hsetlik/GuitarProcessorH7/DSPPapers/paper_links.md

# DSP Papers

I don't want to track all these big pdfs in git, so I'll include this file with names and links to the papers in here

- "About this reverberation business" Moorer 1979: (https://www.music.mcgill.ca/~gary/courses/papers/Moorer-Reverb-CMJ-1979.pdf)
- "Designing multi-channel reverberators" Stautner and Puckette 1982: (https://www.ee.columbia.edu/~dpwe/e4896/papers/StautP82-reverb.pdf)
- "Effect Design" Dattorro 1997: (https://ccrma.stanford.edu/~dattorro/EffectDesignPart1.pdf)
