hsetlik/GuitarProcessorH7/Simulations/OutputStageSim.asc

C1: cap; 4n7
C2: cap; 4n7
C3: cap; 100n
C4: cap; 100n
R1: res; 1k
R2: res; 1k
R3: res; 100k
R4: res; 100k
R5: res; 51k
R6: res; 51k
R10: res; 100k
R11: res; 100k
U1: LT1058
U4: LT1058
V1: voltage; SINE(0.9 0.707 220 0 0 180)
V2: voltage; 9
V3: voltage; SINE(0.9 0.707 220)
Named nets: +9, 0, vg, LOL, LOR
.tran 0 80m 60m
