hsetlik/GuitarProcessorH7/GuitarProcessorBoard/GuitarProcessorBoard.kicad_pcb

## KiCad design GuitarProcessorBoard/GuitarProcessorBoard.kicad_pcb (2026-05-24)

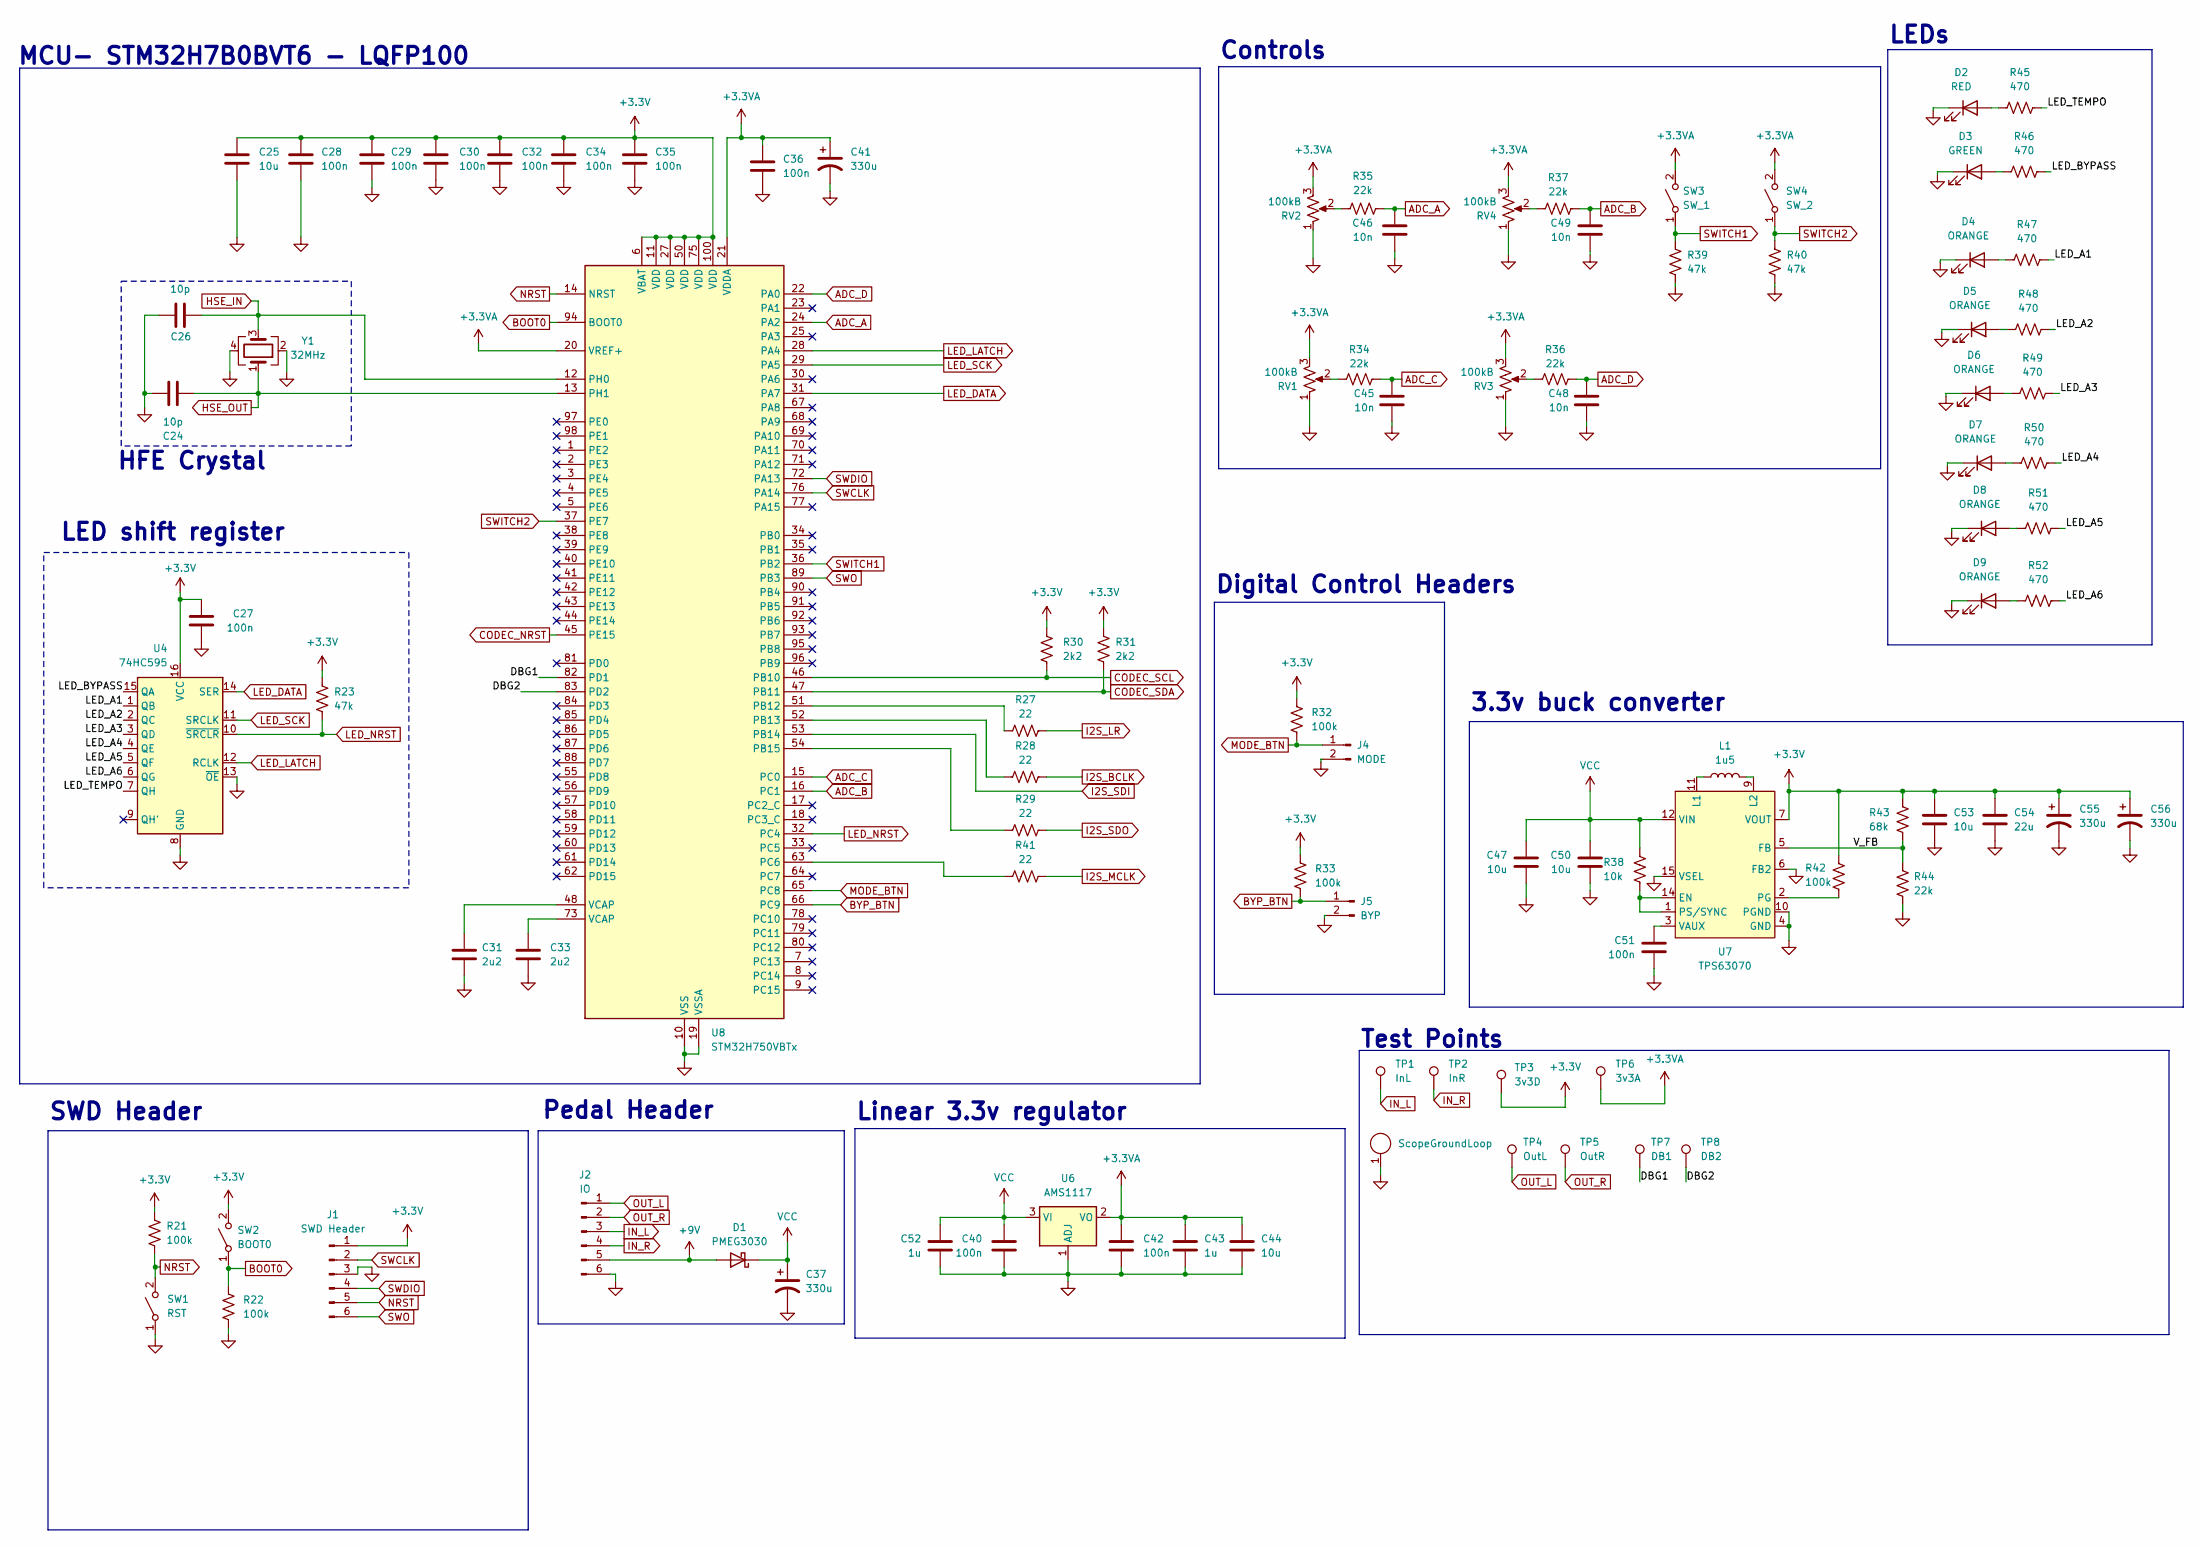
[picture p1: schematic MCU.kicad_sch]

Parts:
C24, C26: 10p; C_0805_2012Metric
C25, C44, C47, C50, C53: 10u; C_0805_2012Metric
C27, C28, C29, C30, C32, C34, C35, C36, C40, C42, C51: 100n; C_0805_2012Metric
C31, C33: 2u2; C_0805_2012Metric
C37, C41, C55, C56: 330u; CP_Radial_D5.0mm_P2.50mm
C43, C52: 1u; C_0805_2012Metric
C45, C46, C48, C49: 10n; C_0805_2012Metric
C54: 22u; C_0805_2012Metric
D1: PMEG3030; D_SOD-123
D2: RED; LED_D3.0mm
D3: GREEN; LED_D3.0mm
D4, D5, D6, D7, D8, D9: ORANGE; LED_D3.0mm
J1: SWD Header; PinHeader_1x06_P2.54mm_Vertical
J2: IO; PinHeader_1x06_P2.54mm_Vertical
J3: ScopeGroundLoop; THT_GND_WIRE
J4: MODE; PinHeader_1x02_P2.54mm_Vertical
J5: BYP; PinHeader_1x02_P2.54mm_Vertical
L1: 1u5; L_Coilcraft_XAL4020-XXX
R21, R22, R32, R33, R42: 100k; R_0805_2012Metric
R23, R39, R40: 47k; R_0805_2012Metric
R27, R28, R29, R41: 22; R_0805_2012Metric
R30, R31: 2k2; R_0805_2012Metric
R34, R35, R36, R37, R44: 22k; R_0805_2012Metric
R38: 10k; R_0805_2012Metric
R43: 68k; R_0805_2012Metric
R45, R46, R47, R48, R49, R50, R51, R52: 470; R_0805_2012Metric
RV1, RV2, RV3, RV4: 100kB; Potentiometer_Alpha_RD901F-40-00D_Single_Vertical_CircularH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
SW1: RST; SW_SPST_B3U-1000P
SW2: BOOT0; SW_SPST_B3U-1000P
SW3: SW_1; SW_TH_Tactile_Omron_B3F-102x
SW4: SW_2; SW_TH_Tactile_Omron_B3F-102x
TP1: InL; TestPoint_THTPad_D2.0mm_Drill1.0mm_VAL
TP2: InR; TestPoint_THTPad_D2.0mm_Drill1.0mm_VAL
TP3: 3v3D; TestPoint_THTPad_D2.0mm_Drill1.0mm_VAL
TP4: OutL; TestPoint_THTPad_D2.0mm_Drill1.0mm_VAL
TP5: OutR; TestPoint_THTPad_D2.0mm_Drill1.0mm_VAL
TP6: 3v3A; TestPoint_THTPad_D2.0mm_Drill1.0mm_VAL
TP7: DB1; TestPoint_THTPad_D2.0mm_Drill1.0mm_VAL
TP8: DB2; TestPoint_THTPad_D2.0mm_Drill1.0mm_VAL
U4: 74HC595; SOIC-16_3.9x9.9mm_P1.27mm
U6: AMS1117; SOT-223-3_TabPin2
U7: TPS63070; Converter_DCDC_TXN_QFN15
U8: STM32H750VBTx; LQFP-100_14x14mm_P0.5mm
Y1: 32MHz; Crystal_SMD_EuroQuartz_MT-4Pin_3.2x2.5mm

Connections:
+3.3V: C25.1, C27.1, C28.1, C29.1, C30.1, C32.1, C34.1, C35.1, C53.1, C54.1, C55.1, C56.1, J1.1, R21.1, R23.1, R30.1, R31.1, R32.1, R33.1, R42.1, R43.1, SW2.2 (B), TP3.1 (1_1), U4.16 (VCC), U7.7 (VOUT), U7.8 (VOUT), U8.6 (VBAT), U8.11 (VDD), U8.27 (VDD), U8.50 (VDD), U8.75 (VDD), U8.100 (VDD)
+3.3VA: C36.1, C41.1, C42.2, C43.1, C44.1, RV1.3, RV2.3, RV3.3, RV4.3, SW3.2 (B), SW4.2 (B), TP6.1 (1_1), U6.2 (VO), U8.20 (VREF+), U8.21 (VDDA); also elsewhere on the board
+9V: D1.2 (A), J2.5
/MCU/DBG1: TP7.1 (1_1), U8.82 (PD1)
/MCU/DBG2: TP8.1 (1_1), U8.83 (PD2)
/MCU/LED_A1: R47.2, U4.1 (QB)
/MCU/LED_A2: R48.2, U4.2 (QC)
/MCU/LED_A3: R49.2, U4.3 (QD)
/MCU/LED_A4: R50.2, U4.4 (QE)
/MCU/LED_A5: R51.2, U4.5 (QF)
/MCU/LED_A6: R52.2, U4.6 (QG)
/MCU/LED_BYPASS: R46.2, U4.15 (QA)
/MCU/LED_TEMPO: R45.2, U4.7 (QH)
/MCU/V_FB: R43.2, R44.1, U7.5 (FB)
ADC_A: C46.1, R35.2, U8.24 (PA2)
ADC_B: C49.1, R37.2, U8.16 (PC1)
ADC_C: C45.1, R34.2, U8.15 (PC0)
ADC_D: C48.1, R36.2, U8.22 (PA0)
BOOT0: R22.1, SW2.1 (A), U8.94 (BOOT0)
BYP_BTN: J5.1, R33.2, U8.66 (PC9)
CODEC_NRST: U8.45 (PE15); also elsewhere on the board
CODEC_SCL: R30.2, U8.46 (PB10); also elsewhere on the board
CODEC_SDA: R31.2, U8.47 (PB11); also elsewhere on the board
GND: C24.1, C25.2, C26.1, C27.2, C28.2, C29.2, C30.2, C31.2, C32.2, C33.2, C34.2, C35.2, C36.2, C37.2, C40.1, C41.2, C42.1, C43.2, C44.2, C45.2, C46.2, C47.2, C48.2, C49.2, C50.2, C51.2, C52.2, C53.2, C54.2, C55.2, C56.2, D2.1 (K), D3.1 (K), D4.1 (K), D5.1 (K), D6.1 (K), D7.1 (K), D8.1 (K), D9.1 (K), J1.3, J2.6, J3.1, J4.2, J5.2, R22.2, R39.2, R40.2, R44.2, RV1.1, RV2.1, RV3.1, RV4.1, SW1.1 (A), U4.8 (GND), U4.13 (~OE), U6.1 (ADJ), U7.4 (GND), U7.6 (FB2), U7.10 (PGND), U7.15 (VSEL), U8.10 (VSS), U8.19 (VSSA), U8.26 (VSS), U8.49 (VSS), U8.74 (VSS), U8.99 (VSS), Y1.2, Y1.4; also elsewhere on the board
HSE_IN: C26.2, U8.12 (PH0), Y1.3
HSE_OUT: C24.2, U8.13 (PH1), Y1.1
I2S_BCLK: R28.2; also elsewhere on the board
I2S_LR: R27.2; also elsewhere on the board
I2S_MCLK: R41.2; also elsewhere on the board
I2S_SDI: U8.53 (PB14); also elsewhere on the board
I2S_SDO: R29.2; also elsewhere on the board
IN_L: J2.3, TP1.1 (1_1); also elsewhere on the board
IN_R: J2.4, TP2.1 (1_1); also elsewhere on the board
LED_DATA: U4.14 (SER), U8.31 (PA7)
LED_LATCH: U4.12 (RCLK), U8.28 (PA4)
LED_NRST: R23.2, U4.10 (~SRCLR), U8.32 (PC4)
LED_SCK: U4.11 (SRCLK), U8.29 (PA5)
MODE_BTN: J4.1, R32.2, U8.65 (PC8)
NRST: J1.5, R21.2, SW1.2 (B), U8.14 (NRST)
unnamed: C31.1, U8.48 (VCAP)
unnamed: C33.1, U8.73 (VCAP)
unnamed: D2.2 (A), R45.1
unnamed: D3.2 (A), R46.1
unnamed: D4.2 (A), R47.1
unnamed: D5.2 (A), R48.1
unnamed: D6.2 (A), R49.1
unnamed: D7.2 (A), R50.1
unnamed: D8.2 (A), R51.1
unnamed: D9.2 (A), R52.1
unnamed: R34.1, RV1.2
unnamed: R35.1, RV2.2
unnamed: R36.1, RV3.2
unnamed: R37.1, RV4.2
unnamed: R38.2, U7.1 (PS/SYNC), U7.14 (EN)
unnamed: L1.1, U7.11 (L1)
unnamed: L1.2, U7.9 (L2)
unnamed: R42.2, U7.2 (PG)
unnamed: C51.1, U7.3 (VAUX)
unnamed: R27.1, U8.51 (PB12)
unnamed: R28.1, U8.52 (PB13)
unnamed: R29.1, U8.54 (PB15)
unnamed: R41.1, U8.63 (PC6)
OUT_L: J2.1, TP4.1 (1_1); also elsewhere on the board
OUT_R: J2.2, TP5.1 (1_1); also elsewhere on the board
SWCLK: J1.2, U8.76 (PA14)
SWDIO: J1.4, U8.72 (PA13)
SWITCH1: R39.1, SW3.1 (A), U8.36 (PB2)
SWITCH2: R40.1, SW4.1 (A), U8.37 (PE7)
SWO: J1.6, U8.89 (PB3)
VCC: C37.1, C40.2, C47.1, C50.1, C52.1, D1.1 (K), R38.1, U6.3 (VI), U7.12 (VIN), U7.13 (VIN); also elsewhere on the board

Notes on the sheet:
Pedal Header
3.3v buck converter
Linear 3.3v regulator
LED shift register
Test Points
HFE Crystal
LEDs
MCU- STM32H7B0BVT6 - LQFP100
SWD Header
Controls
Digital Control Headers

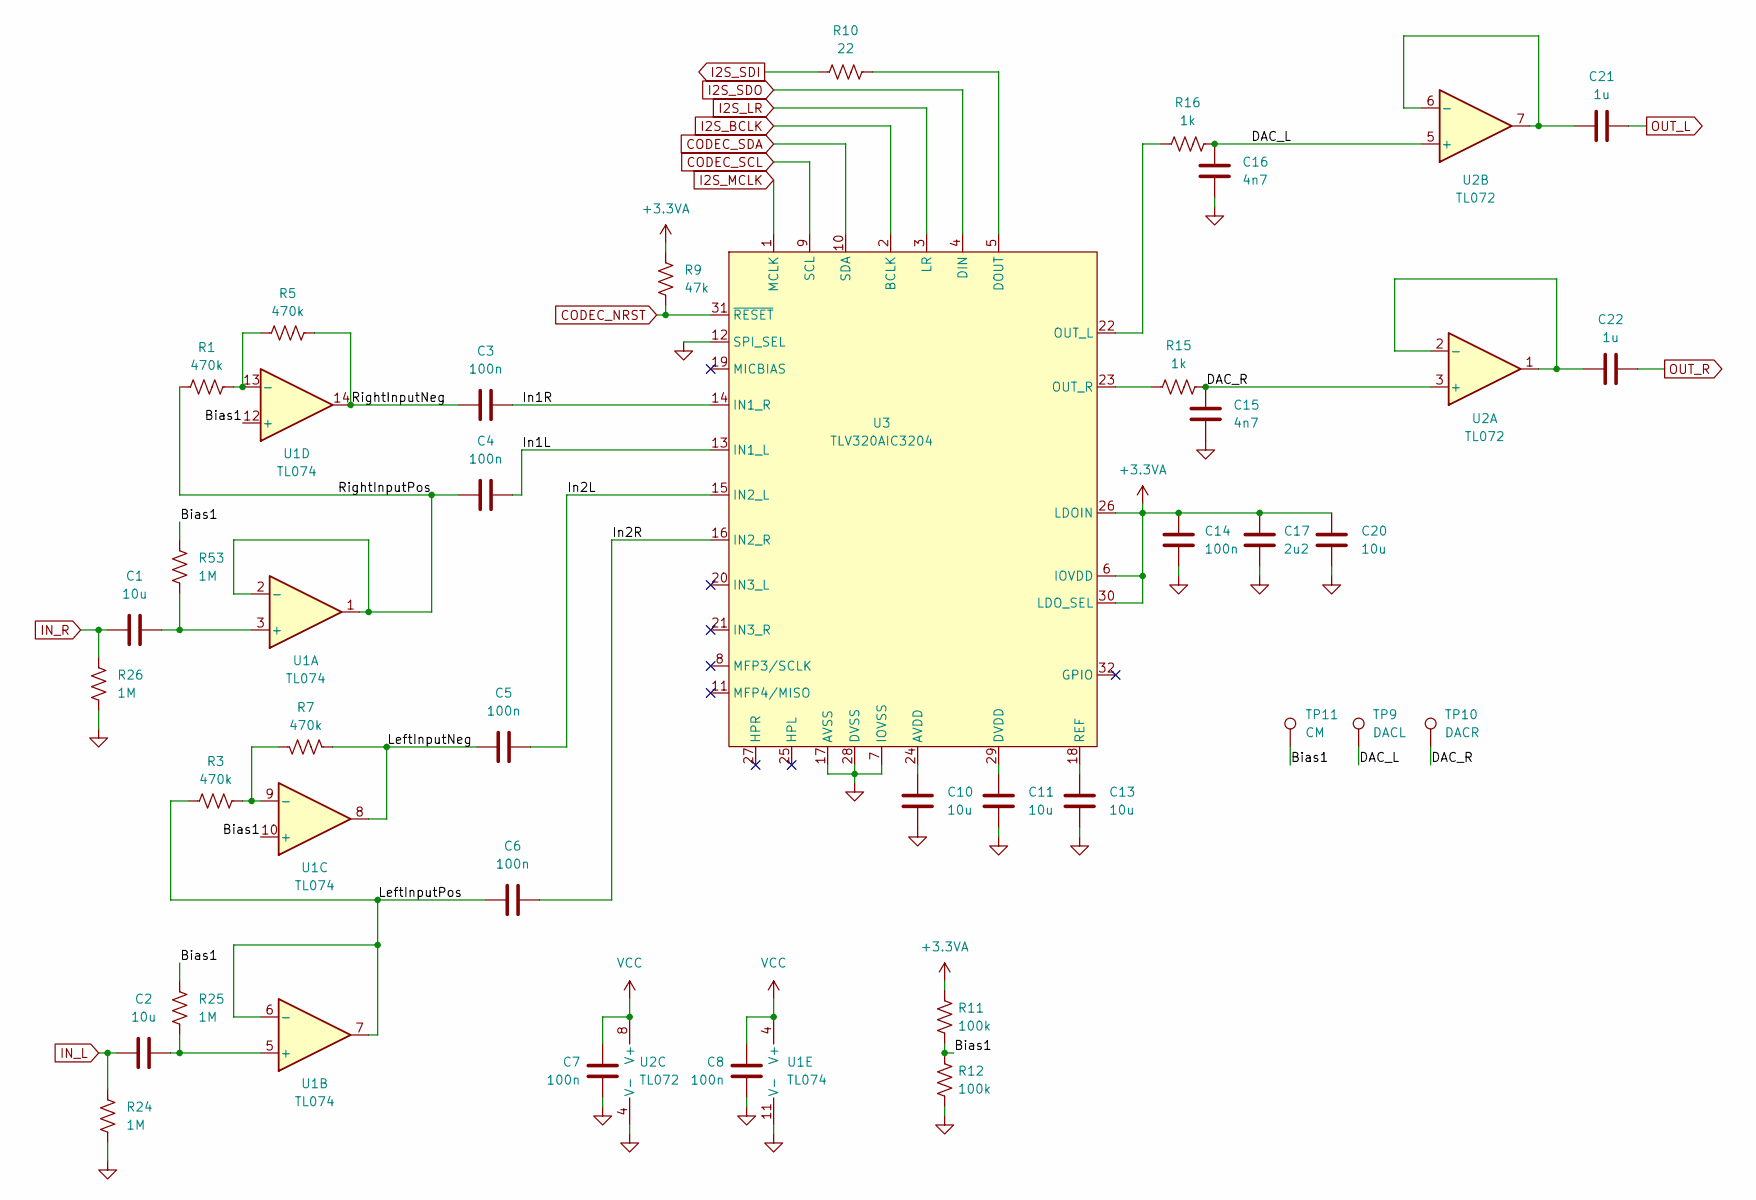
[picture p2: schematic Audio.kicad_sch]

Parts:
C1, C2, C10, C11, C13, C20: 10u; C_0805_2012Metric
C3, C4, C5, C6, C7, C8, C14: 100n; C_0805_2012Metric
C15, C16: 4n7; C_0805_2012Metric
C17: 2u2; C_0805_2012Metric
C21, C22: 1u; C_0805_2012Metric
R1, R3, R5, R7: 470k; R_0805_2012Metric
R9: 47k; R_0805_2012Metric
R10: 22; R_0805_2012Metric
R11, R12: 100k; R_0805_2012Metric
R15, R16: 1k; R_0805_2012Metric
R24, R25, R26, R53: 1M; R_0805_2012Metric
TP9: DACL; TestPoint_THTPad_D2.0mm_Drill1.0mm_VAL
TP10: DACR; TestPoint_THTPad_D2.0mm_Drill1.0mm_VAL
TP11: CM; TestPoint_THTPad_D2.0mm_Drill1.0mm_VAL
U1: TL074; SOIC-14_3.9x8.7mm_P1.27mm
U2: TL072; SOIC-8_3.9x4.9mm_P1.27mm
U3: TLV320AIC3204; VQFN-32-1EP_5x5mm_P0.5mm_EP3.1x3.1mm

Connections:
+3.3VA: C14.1, C17.1, C20.1, R9.1, R11.1, U3.6 (IOVDD), U3.26 (LDOIN), U3.30 (LDO_SEL); also elsewhere on the board
/Audio/Bias1: R11.2, R12.1, R25.1, R53.1, TP11.1 (1_1), U1.10 (+), U1.12 (+)
/Audio/DAC_L: C16.1, R16.2, TP9.1 (1_1), U2.5 (+)
/Audio/DAC_R: C15.1, R15.2, TP10.1 (1_1), U2.3 (+)
/Audio/In1L: C4.2, U3.13 (IN1_L)
/Audio/In1R: C3.2, U3.14 (IN1_R)
/Audio/In2L: C5.2, U3.15 (IN2_L)
/Audio/In2R: C6.2, U3.16 (IN2_R)
/Audio/LeftInputNeg: C5.1, R7.1, U1.8
/Audio/LeftInputPos: C6.1, R3.1, U1.6 (-), U1.7
/Audio/RightInputNeg: C3.1, R5.2, U1.14
/Audio/RightInputPos: C4.1, R1.1, U1.1, U1.2 (-)
CODEC_NRST: R9.2, U3.31 (~RESET); also elsewhere on the board
CODEC_SCL: U3.9 (SCL); also elsewhere on the board
CODEC_SDA: U3.10 (SDA); also elsewhere on the board
GND: C7.2, C8.2, C10.2, C11.2, C13.2, C14.2, C15.2, C16.2, C17.2, C20.2, R12.2, R24.2, R26.2, U1.11 (V-), U2.4 (V-), U3.7 (IOVSS), U3.12 (SPI_SEL), U3.17 (AVSS), U3.28 (DVSS), U3.33 (TP); also elsewhere on the board
I2S_BCLK: U3.2 (BCLK); also elsewhere on the board
I2S_LR: U3.3 (LR); also elsewhere on the board
I2S_MCLK: U3.1 (MCLK); also elsewhere on the board
I2S_SDI: R10.1; also elsewhere on the board
I2S_SDO: U3.4 (DIN); also elsewhere on the board
IN_L: C2.1, R24.1; also elsewhere on the board
IN_R: C1.1, R26.1; also elsewhere on the board
unnamed: C1.2, R53.2, U1.3 (+)
unnamed: C2.2, R25.2, U1.5 (+)
unnamed: R3.2, R7.2, U1.9 (-)
unnamed: R1.2, R5.1, U1.13 (-)
unnamed: C22.1, U2.1, U2.2 (-)
unnamed: C21.1, U2.6 (-), U2.7
unnamed: C10.1, U3.24 (AVDD)
unnamed: R10.2, U3.5 (DOUT)
unnamed: C11.1, U3.29 (DVDD)
unnamed: R16.1, U3.22 (OUT_L)
unnamed: R15.1, U3.23 (OUT_R)
unnamed: C13.1, U3.18 (REF)
OUT_L: C21.2; also elsewhere on the board
OUT_R: C22.2; also elsewhere on the board
VCC: C7.1, C8.1, U1.4 (V+), U2.8 (V+); also elsewhere on the board

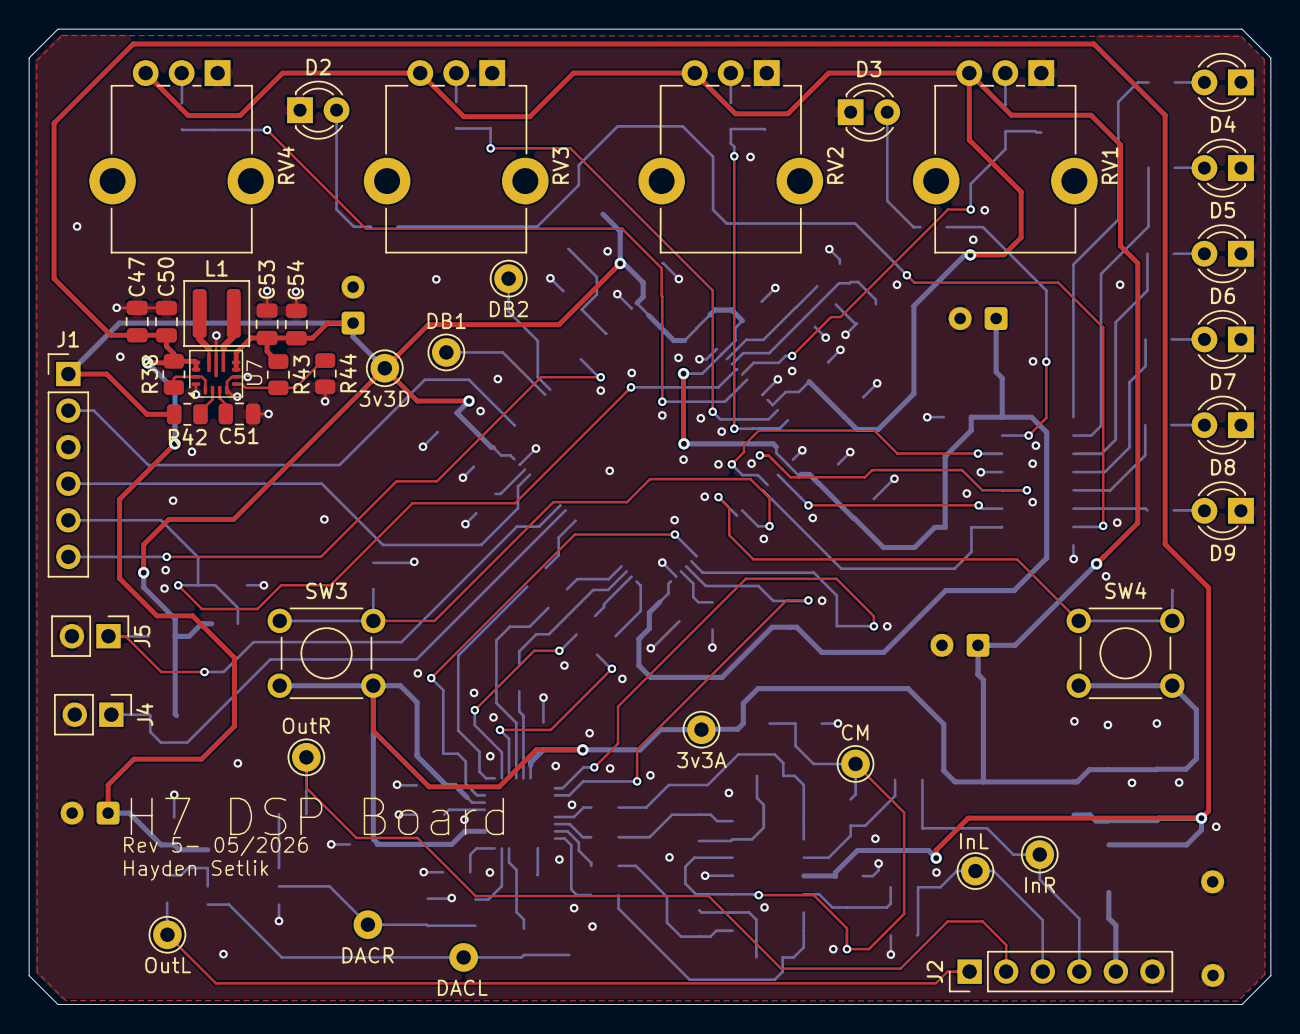
[picture p3: board GuitarProcessorBoard.kicad_pcb from above]

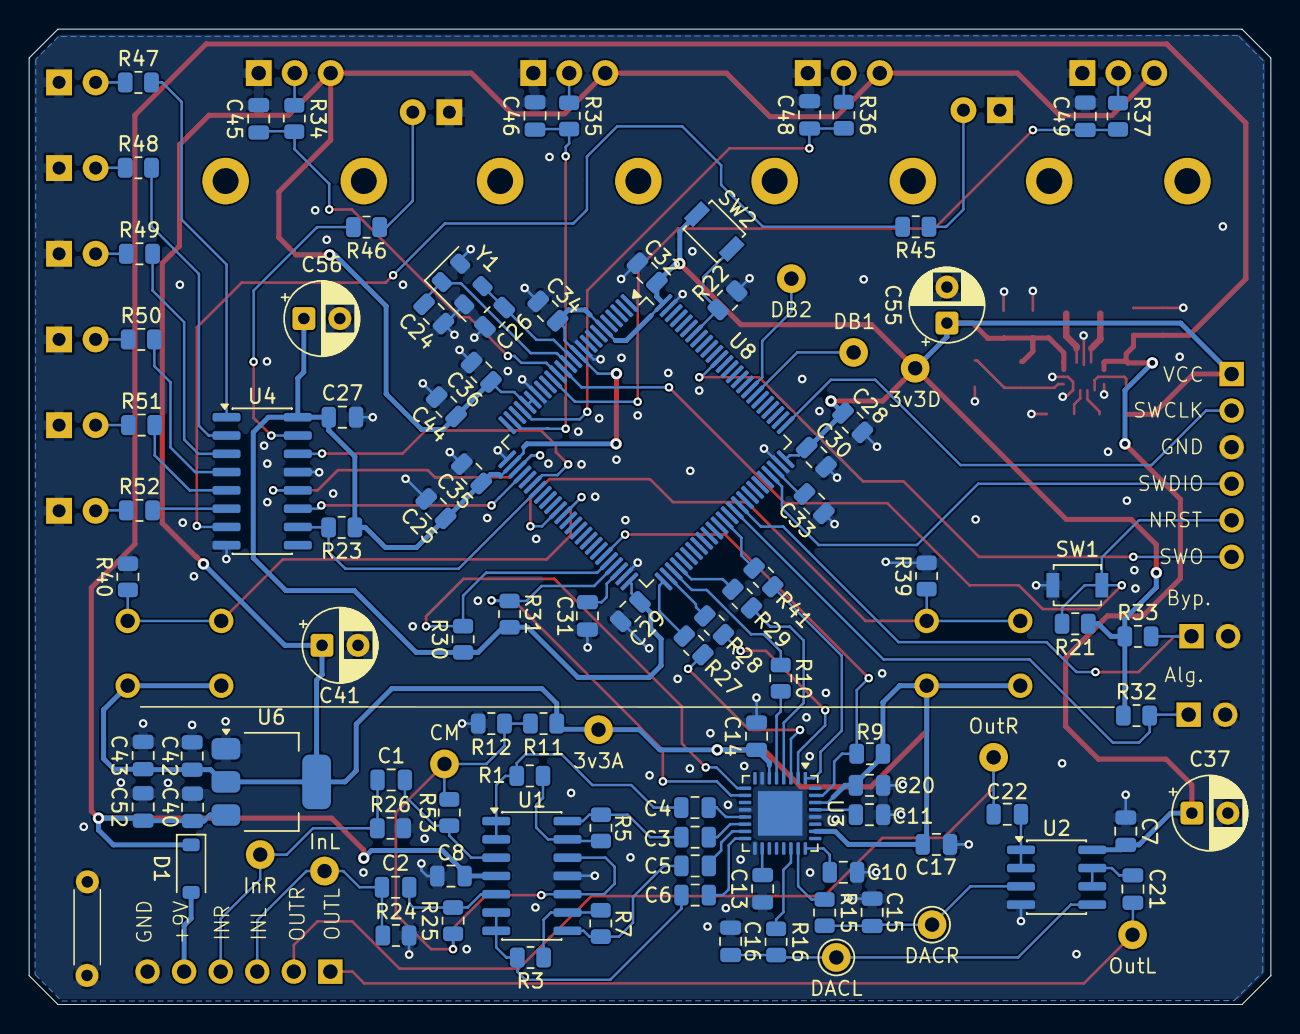
[picture p4: board GuitarProcessorBoard.kicad_pcb from below]

Board: 4 copper layers, 86.3 x 67.8 mm, 134 parts (96 on the bottom side), 93 nets.
