hsetlik/GuitarProcessorH7/GuitarProcessorFirmware/Core/Src/main.c

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
/* Includes ------------------------------------------------------------------*/
#include "main.h"

/* USER CODE BEGIN Includes */
#include "Button.h"
#include "stm32h7xx_hal.h"
#include "stm32h7xx_hal_adc.h"
#include "stm32h7xx_hal_adc_ex.h"
#include "stm32h7xx_hal_def.h"
#include "stm32h7xx_hal_gpio.h"
#include "stm32h7xx_hal_tim.h"
#include "tlv320aic3204.h"
#include "PedalState.h"
#include "FxProcessor.h"
/* USER CODE END Includes */

/* USER CODE BEGIN PM */
#define INPUT_DC_OFFSET 100000
/* USER CODE END PM */

ADC_HandleTypeDef hadc1;
DMA_HandleTypeDef hdma_adc1;

I2C_HandleTypeDef hi2c2;

I2S_HandleTypeDef hi2s2;
DMA_HandleTypeDef hdma_spi2_rx;
DMA_HandleTypeDef hdma_spi2_tx;

SPI_HandleTypeDef hspi1;
DMA_HandleTypeDef hdma_spi1_tx;

TIM_HandleTypeDef htim3;
TIM_HandleTypeDef htim4;
TIM_HandleTypeDef htim6;
TIM_HandleTypeDef htim7;

/* USER CODE BEGIN PV */
// buffers for the input & output audio streams
isample_t adcBuf[AUDIO_BUF_SIZE * 4]  __attribute__((section(".dma_buf")));
float inputBufLeft[AUDIO_BUF_SIZE];
float inputBufRight[AUDIO_BUF_SIZE];
float outputBufLeft[AUDIO_BUF_SIZE];
float outputBufRight[AUDIO_BUF_SIZE];
isample_t dacBuf[AUDIO_BUF_SIZE * 4] __attribute__((section(".dma_buf")));
static isample_t* adcPtr = adcBuf;
static isample_t* dacPtr = dacBuf;
// flags
volatile bool chunkReady = false;
volatile bool ledUpdateNeeded = false;
volatile bool flagCheckNeeded = false;
volatile bool processRunning = false;
isample_t leftDcBias = 0;

// knob values and ADC buffer
volatile uint16_t knobValueBuf[4] __attribute__((section(".dma_buf")));
volatile bool knobValuesReady = false;

// button objects
button_t leftBtn;
button_t rightBtn;

// state
uint8_t ledData __attribute__((section(".dma_buf")));
pedal_state_t ps;
fx_processor_t fx;

/* USER CODE END PV */

void SystemClock_Config(void);
static void MPU_Config(void);
static void MX_GPIO_Init(void);
static void MX_DMA_Init(void);
static void MX_ADC1_Init(void);
static void MX_I2C2_Init(void);
static void MX_I2S2_Init(void);
static void MX_SPI1_Init(void);
static void MX_TIM3_Init(void);
static void MX_TIM4_Init(void);
static void MX_TIM7_Init(void);
static void MX_TIM6_Init(void);
/* USER CODE BEGIN PFP */
void startKnobADC();
void loadInputBuf(isample_t* ptr);
void loadOutputBuf(isample_t* dac);
/* USER CODE END PFP */

/* USER CODE BEGIN 0 */
bool ledUpdateDue() {
  return ledUpdateNeeded;
}

void updateLedData(uint8_t data){
  ledData = data;
  HAL_StatusTypeDef ledStatus = HAL_SPI_Transmit_DMA(&LED_SPI, &ledData, 1); 
  if(ledStatus != HAL_OK){
    Error_Handler();
  }
  ledUpdateNeeded = false;
}

bool algSwitchDebounce(){
	static uint16_t switchStates = 0xFFFF;
	switchStates = (switchStates << 1)
			| HAL_GPIO_ReadPin(MODE_GPIO_Port, MODE_Pin);
	return switchStates == 0xFFF0;
}

void setDBG1Level(bool isHigh){
  GPIO_PinState state = (GPIO_PinState)isHigh;
  HAL_GPIO_WritePin(DBG1_GPIO_Port, DBG1_Pin, state);
}

void setDBG2Level(bool isHigh){
  GPIO_PinState state = (GPIO_PinState)isHigh;
  HAL_GPIO_WritePin(DBG2_GPIO_Port, DBG2_Pin, state);
}

uint16_t i2c_scan(I2C_HandleTypeDef *hi2c) {
    for (uint8_t addr = 1; addr < 128; addr++) {
        // HAL expects the address left-shifted by 1
        if (HAL_I2C_IsDeviceReady(hi2c, addr << 1, 1, 10) == HAL_OK) {
            // device found at 7-bit address `addr`
          return (uint16_t)(addr << 1);   
        }
    }
    Error_Handler();
    return 0;
}

/* USER CODE END 0 */

/**
  * @brief  The application entry point.
  * @retval int
  */
int main(void)
{

  /* MPU Configuration--------------------------------------------------------*/
  MPU_Config();

  /* MCU Configuration--------------------------------------------------------*/

  /* Reset of all peripherals, Initializes the Flash interface and the Systick. */
  HAL_Init();

  /* Configure the system clock */
  SystemClock_Config();

  /* Initialize all configured peripherals */
  MX_GPIO_Init();
  MX_DMA_Init();
  MX_ADC1_Init();
  MX_I2C2_Init();
  MX_I2S2_Init();
  MX_SPI1_Init();
  MX_TIM3_Init();
  MX_TIM4_Init();
  MX_TIM7_Init();
  MX_TIM6_Init();
  /* USER CODE BEGIN 2 */
  // find any valid I2C devices
  //uint16_t address = i2c_scan(&hi2c2);
  // initialize the audio codec
  HAL_StatusTypeDef tlvStatus = TLV_quickInit_stereoGuitarPedal();
  if(tlvStatus != HAL_OK){
    Error_Handler();
  }

  HAL_Delay(150);

  HAL_StatusTypeDef dmaStatus = HAL_I2SEx_TransmitReceive_DMA(&hi2s2, (uint16_t*)dacBuf, (uint16_t*)adcBuf, AUDIO_BUF_SIZE * sizeof(isample_t));
  if(dmaStatus != HAL_OK){
    Error_Handler();
  }

  //TLV_checkFlags();

  // calibrate the ADC
  if(HAL_ADCEx_Calibration_Start(&hadc1, ADC_CALIB_OFFSET, ADC_SINGLE_ENDED) != HAL_OK){
    Error_Handler();
  }

  // start the timer for the knobs
  if(HAL_TIM_Base_Start(&htim4) != HAL_OK){
    Error_Handler();
  }

  startKnobADC();

  PedalState_init(&ps);
  HAL_GPIO_WritePin(LED_NRST_GPIO_Port, LED_NRST_Pin, GPIO_PIN_SET);
  // start the timer for the LED updating
  if(HAL_TIM_Base_Start_IT(&htim3) != HAL_OK){
    Error_Handler();
  }
  HAL_Delay(350);
  // initialize the button objects
  button_init(&leftBtn, SW_1_GPIO_Port, SW_1_Pin, true);
  button_init(&rightBtn, SW_2_GPIO_Port, SW_2_Pin, true);
   // start the timer for checking the buttons
  if(HAL_TIM_Base_Start_IT(&htim7) != HAL_OK){
    Error_Handler();
  } 
  init_dc_measurement_buf();
  // // start the flag checking timer
  // if(HAL_TIM_Base_Start_IT(&htim6) != HAL_OK){
  //   Error_Handler();
  // } 
  // // enable DC measurement on the ADCs
  // if(TLV_enableDcMeasurement() != HAL_OK){
  //   Error_Handler();
  // }
  // initialize the fx processor
  fx = create_fx_processor();
  /* USER CODE END 2 */

  /* Infinite loop */
  /* USER CODE BEGIN WHILE */
  while (1)
  {
    if(chunkReady){
      //do processing here
      setDBG2Level(true);
      loadInputBuf(adcPtr);
      processRunning = true;
      setDBG1Level(true);
      process_fx_stereo(fx, inputBufLeft, inputBufRight, outputBufLeft, outputBufRight, AUDIO_BUF_SIZE);
      setDBG1Level(false);
      processRunning = false;
      loadOutputBuf(dacPtr);
      setDBG2Level(false);
      chunkReady = false;
    }
    if(knobValuesReady){
      ps.knobA = (float)knobValueBuf[0] / 4096.0f;
      ps.knobB = (float)knobValueBuf[1] / 4096.0f;
      ps.knobC = (float)knobValueBuf[2] / 4096.0f;
      ps.knobD = (float)knobValueBuf[3] / 4096.0f;
      update_params(fx, &ps);
      knobValuesReady = false;
      startKnobADC();
    }
    if(ledUpdateDue()){
      // check the switches while we're here
      ps.fxEngaged = HAL_GPIO_ReadPin(BYP_GPIO_Port, BYP_Pin);
      ps.expButton = HAL_GPIO_ReadPin(MODE_GPIO_Port, MODE_Pin);
      updateLedData(PedalState_getLedData(&ps));
    }
    // if(flagCheckNeeded){
    //   if(TLV_leftDcMeasurementReady()){
    //     leftDcBias = TLV_getDcMeasurementLeft();
    //   }
    //   flagCheckNeeded = false;
    // }
    /* USER CODE END WHILE */

    /* USER CODE BEGIN 3 */
  }
  /* USER CODE END 3 */
}

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
/* USER CODE BEGIN 4 */

// I2S callbacks===================================
void HAL_I2SEx_TxRxCpltCallback(I2S_HandleTypeDef *i2s) {
  if(processRunning){
    Error_Handler();
  }
	adcPtr = &adcBuf[AUDIO_BUF_SIZE * 2];
	dacPtr = &dacBuf[AUDIO_BUF_SIZE * 2];
  chunkReady = true;
}

void HAL_I2SEx_TxRxHalfCpltCallback(I2S_HandleTypeDef *i2s) {
  if(processRunning){
    Error_Handler();
  }
	adcPtr = &adcBuf[0];
	dacPtr = &dacBuf[0];
  chunkReady = true;
}

// void HAL_I2S_ErrorCallback(I2S_HandleTypeDef *hi2s){
//   uint32_t errCode = HAL_I2S_GetError(hi2s);
// }

static inline float sampleToFloat(isample_t value){
    return (float)value / 2147483648.0f;  // 2^31
}

static inline isample_t floatToSample(float value){
  return (isample_t)(value * 2147483648.0f);
}

void loadInputBuf(isample_t* ptr){
  for(uint32_t i = 0; i < AUDIO_BUF_SIZE; ++i){
    inputBufLeft[i] = sampleToFloat(ptr[(i * 2) + 1]);
    inputBufRight[i] = sampleToFloat(ptr[(i * 2)]);
  }
}

void loadOutputBuf(isample_t* dac){
  for(uint32_t i = 0; i < AUDIO_BUF_SIZE; ++i){
    dac[(i * 2) + 1] = floatToSample(outputBufLeft[i]);
    dac[(i * 2)] = floatToSample(outputBufRight[i]);
  } 
}

void HAL_ADC_ConvCpltCallback(ADC_HandleTypeDef *hadc){
  knobValuesReady = true;
}

void HAL_ADC_ErrorCallback(ADC_HandleTypeDef *hadc){
  if(HAL_ADC_GetError(hadc) == HAL_ADC_ERROR_DMA){
    Error_Handler();
  }
}

void startKnobADC(){
  //start the ADC dma stream
  HAL_StatusTypeDef adcStatus = HAL_ADC_Start_DMA(&hadc1, (uint32_t*)knobValueBuf, 4);
  if(adcStatus != HAL_OK){
    Error_Handler();
  }
}

void HAL_TIM_PeriodElapsedCallback(TIM_HandleTypeDef *htim){
  if(htim == &htim7){
    if(button_debounce(&rightBtn)){
      ps.algIdx = (ps.algIdx + 1) % 6;
    }
    if(button_debounce(&leftBtn)){
      if(ps.algIdx == 0){
        ps.algIdx = 5;
      } else {
        ps.algIdx--;
      }
    }
  } else if (htim == &htim3){
    ledUpdateNeeded = true;
  } 
}

//=====================================================================================
/* USER CODE END 4 */

 /* MPU Configuration */

void MPU_Config(void)
{
  MPU_Region_InitTypeDef MPU_InitStruct = {0};

  /* Disables the MPU */
  HAL_MPU_Disable();

  /** Initializes and configures the Region and the memory to be protected
  */
  MPU_InitStruct.Enable = MPU_REGION_ENABLE;
  MPU_InitStruct.Number = MPU_REGION_NUMBER0;
  MPU_InitStruct.BaseAddress = 0x0;
  MPU_InitStruct.Size = MPU_REGION_SIZE_4GB;
  MPU_InitStruct.SubRegionDisable = 0x87;
  MPU_InitStruct.TypeExtField = MPU_TEX_LEVEL0;
  MPU_InitStruct.AccessPermission = MPU_REGION_NO_ACCESS;
  MPU_InitStruct.DisableExec = MPU_INSTRUCTION_ACCESS_DISABLE;
  MPU_InitStruct.IsShareable = MPU_ACCESS_SHAREABLE;
  MPU_InitStruct.IsCacheable = MPU_ACCESS_NOT_CACHEABLE;
  MPU_InitStruct.IsBufferable = MPU_ACCESS_NOT_BUFFERABLE;

  HAL_MPU_ConfigRegion(&MPU_InitStruct);
  /* Enables the MPU */
  HAL_MPU_Enable(MPU_PRIVILEGED_DEFAULT);

}

/**
  * @brief  This function is executed in case of error occurrence.
  * @retval None
  */
void Error_Handler(void)
{
  /* USER CODE BEGIN Error_Handler_Debug */
  /* User can add his own implementation to report the HAL error return state */
  __disable_irq();
  while (1)
  {
  }
  /* USER CODE END Error_Handler_Debug */
}
#ifdef USE_FULL_ASSERT
/**
  * @brief  Reports the name of the source file and the source line number
  *         where the assert_param error has occurred.
  * @param  file: pointer to the source file name
  * @param  line: assert_param error line source number
  * @retval None
  */
void assert_failed(uint8_t *file, uint32_t line)
{
  /* USER CODE BEGIN 6 */
  /* User can add his own implementation to report the file name and line number,
     ex: printf("Wrong parameters value: file %s on line %d\r\n", file, line) */
  /* USER CODE END 6 */
}
#endif /* USE_FULL_ASSERT */
