hsetlik/GuitarProcessorH7/GuitarProcessorFirmware/GuitarProcessorFirmware.ioc

Mcu.UserName=STM32H750VBTx
PA0.GPIO_Label=ADC_D
PA0.Signal=ADC1_INP16
PA2.GPIO_Label=ADC_A
PA2.Signal=ADCx_INP14
PA4.GPIO_Label=LED_LATCH
PA4.Signal=SPI1_NSS
PA5.GPIO_Label=LED_CLK
PA5.Signal=SPI1_SCK
PA7.GPIO_Label=LED_DATA
PA7.Signal=SPI1_MOSI
PB10.GPIO_Label=CODEC_SCL
PB10.Signal=I2C2_SCL
PB11.GPIO_Label=CODEC_SDA
PB11.Signal=I2C2_SDA
PB12.Signal=I2S2_WS
PB13.Signal=I2S2_CK
PB14.Signal=I2S2_SDI
PB15.Signal=I2S2_SDO
PB2.GPIO_Label=SW_1
PB2.Signal=GPIO_Input
PC0.GPIO_Label=ADC_C
PC0.Signal=ADCx_INP10
PC1.GPIO_Label=ADC_B
PC1.Signal=ADCx_INP11
PC4.GPIO_Label=LED_NRST
PC4.Signal=GPIO_Output
PC6.Signal=I2S2_MCK
PC8.GPIO_Label=MODE
PC8.Signal=GPIO_Input
PC9.GPIO_Label=BYP
PC9.Signal=GPIO_Input
PD1.GPIO_Label=DBG1
PD1.Signal=GPIO_Output
PD2.GPIO_Label=DBG2
PD2.Signal=GPIO_Output
PE15.GPIO_Label=CODEC_NRST
PE15.Signal=GPIO_Output
PE7.GPIO_Label=SW_2
PE7.Signal=GPIO_Input
