hsetlik/GuitarProcessorH7/Core/Src/main.c

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
/* Includes ------------------------------------------------------------------*/
#include "main.h"

/* USER CODE BEGIN Includes */
#include "FxProcessor.h"
#include "tlv320aic3204.h"
#include "ssd1306.h"
/* USER CODE END Includes */

ADC_HandleTypeDef hadc1;
DMA_HandleTypeDef hdma_adc1;

I2C_HandleTypeDef hi2c1;
I2C_HandleTypeDef hi2c2;

I2S_HandleTypeDef hi2s1;
DMA_HandleTypeDef hdma_spi1_rx;
DMA_HandleTypeDef hdma_spi1_tx;

SPI_HandleTypeDef hspi2;
DMA_HandleTypeDef hdma_spi2_tx;

TIM_HandleTypeDef htim3;
TIM_HandleTypeDef htim4;

/* USER CODE BEGIN PV */
fx_processor_t fx;

uint16_t knobAdcData[4];

volatile uint8_t ledsReady = 1;
uint8_t ledData = 0x00;

/* USER CODE END PV */

void SystemClock_Config(void);
static void MPU_Config(void);
static void MX_GPIO_Init(void);
static void MX_DMA_Init(void);
static void MX_ADC1_Init(void);
static void MX_I2C1_Init(void);
static void MX_I2C2_Init(void);
static void MX_I2S1_Init(void);
static void MX_SPI2_Init(void);
static void MX_TIM4_Init(void);
static void MX_TIM3_Init(void);
/* USER CODE BEGIN PFP */
// call this to update the LEDs
void checkLEDs();

/* USER CODE END PFP */

/* USER CODE BEGIN 0 */

//I2S stuff-----------------
int32_t adcBuf[BUFFER_SIZE];
int32_t dacBuf[BUFFER_SIZE];
static volatile int32_t *adcPtr = &adcBuf[0];
static volatile int32_t *dacPtr = &dacBuf[0];
float inputFloatBuf[BUFFER_FLOAT_SIZE];
float outputFloatBuf[BUFFER_FLOAT_SIZE];

uint8_t bufferReady = 0;

volatile uint8_t displayUpdateNeeded = 0;
//static const uint32_t max32 = 0xFFFFFFFF;
//float u32_to_float(uint32_t val) {
//	float norm = (float)val / (float)max32;
//	return (norm * 2.0f) - 1.0f;
//}
//
//uint32_t float_to_u32(float val) {
//	float norm = (val + 1.0f) / 2.0f;
//	return (uint32_t)(norm * (float)max32);
//}

static const int32_t int32Max = 2147483648;
float i32_to_float(int32_t val) {
	return (float) val / (float) int32Max;
}
int32_t float_to_i32(float val) {
	return (int32_t) (val * (float) int32Max);
}

void convertInputBuffer() {
	for (uint16_t i = 0; i < BUFFER_FLOAT_SIZE; ++i) {
		// convert ADC to the input buf
		inputFloatBuf[i] = i32_to_float(adcPtr[(2 * i) + 1]);

	}
}
void convertOutputBuffer() {
	for (uint16_t i = 0; i < BUFFER_FLOAT_SIZE; ++i) {
		// convert output buf to DAC
		dacPtr[(2 * i) + 1] = float_to_i32(outputFloatBuf[i]);
		// for differential out on the left channel
		dacPtr[2 * i] = dacPtr[(2 * i) + 1] * -1;
	}
}

void HAL_I2SEx_TxRxCpltCallback(I2S_HandleTypeDef *i2s) {
	adcPtr = &adcBuf[BUFFER_SIZE / 2];
	dacPtr = &dacBuf[BUFFER_SIZE / 2];
	bufferReady = 1;
}

void HAL_I2SEx_TxRxHalfCpltCallback(I2S_HandleTypeDef *i2s) {
	adcPtr = &adcBuf[0];
	dacPtr = &dacBuf[0];
	bufferReady = 1;
}

void HAL_SPI_TxCpltCallback(SPI_HandleTypeDef*) {
	ledsReady = 1;
}

// Knob ADC callback----------------------

void HAL_ADC_ErrorCallback(ADC_HandleTypeDef *adc) {
	Error_Handler();
}
void HAL_ADC_ConvCpltCallback(ADC_HandleTypeDef *adc) {
	static uint16_t prevValues[4] = { 0, 0, 0, 0 };
	/*NOTE: the channels are ordered:
	 * Knob A
	 * Knob B
	 * Knob C
	 * Exp. input
	 * */
	for (uint8_t i = 0; i < 4; i++) {
		if (knobAdcData[i] != prevValues[i]) {
			prevValues[i] = knobAdcData[i];
			fx_control_moved(fx, i, knobAdcData[i]);
		}
	}

}

//void HAL_ADC_ConvHalfCpltCallback(ADC_HandleTypeDef* adc) {
//	static uint16_t prevValues[2] = { 0, 0 };
//	/*NOTE: the channels are ordered:
//	 * Knob C
//	 * Exp. Input
//	 * */
//	for (uint8_t i = 0; i < 2; i++) {
//		if (knobAdcData[i + 2] != prevValues[i]) {
//			prevValues[i] = knobAdcData[i + 2];
//			fx_control_moved(fx, i + 2, knobAdcData[i + 2]);
//		}
//	}
//
//}

// Display I2C callback------------------------------
void HAL_I2C_MemTxCpltCallback(I2C_HandleTypeDef*) {
	ssd1306_TxFinished();
}

void HAL_I2C_ErrorCallback(I2C_HandleTypeDef* i2c){
	Error_Handler();
}
//
void checkLEDs() {
	static uint32_t lastCheck = 0;
	// this limits the LEDs to refreshing no more than ~25x a second
	const uint32_t minUpdateMs = 40;
	if (ledsReady && (HAL_GetTick() - lastCheck) >= minUpdateMs) {
		lastCheck = HAL_GetTick();
		uint8_t bits = fx_get_led_byte(fx);
		if (bits != ledData) {
			ledData = bits;
			// even with the prescaler at 128 this transmission only takes like 10.2 microseconds,
			// but we have the hardware DMAs so why not optimize
			HAL_SPI_Transmit_DMA(&hspi2, &ledData, 1);
			ledsReady = 0;
		}
	}
}

const uint32_t switchUpdateMs = 10;

uint8_t algSwitchDebounce() {
	static uint16_t switchStates = 0;
	switchStates = (switchStates << 1)
			| HAL_GPIO_ReadPin(MODE_GPIO_Port, MODE_Pin);
	return switchStates == 0x000F;
}

void checkSwitches() {
	static uint32_t lastSwitchCheck = 0;
	uint32_t now = HAL_GetTick();
	static GPIO_PinState fxActive = GPIO_PIN_SET;
	if (now - lastSwitchCheck >= switchUpdateMs) {
		lastSwitchCheck = now;
		if (algSwitchDebounce()) {
			fx_advance_alg(fx);
		}
		GPIO_PinState bypState = HAL_GPIO_ReadPin(BYP_GPIO_Port, BYP_Pin);
		if (bypState != fxActive) {
			fxActive = bypState;
			fx_set_bypass(fx, (uint8_t) bypState);
		}
	}

}

// timer stuff
void HAL_TIM_PeriodElapsedCallback(TIM_HandleTypeDef *tim) {
	if (tim == &htim4) {
		HAL_StatusTypeDef adcStatus = HAL_ADCEx_MultiModeStart_DMA(&hadc1, (uint32_t*) knobAdcData,
				sizeof(knobAdcData));
		if (adcStatus != HAL_OK && adcStatus != HAL_BUSY) {
			Error_Handler();
		}
	} else if (ssd1306_DMAReady() > 0) {
		displayUpdateNeeded = 1;
	}
}

/* USER CODE END 0 */

/**
  * @brief  The application entry point.
  * @retval int
  */
int main(void)
{

  /* MPU Configuration--------------------------------------------------------*/
  MPU_Config();

  /* MCU Configuration--------------------------------------------------------*/

  /* Reset of all peripherals, Initializes the Flash interface and the Systick. */
  HAL_Init();

  /* Configure the system clock */
  SystemClock_Config();

  /* Initialize all configured peripherals */
  MX_GPIO_Init();
  MX_DMA_Init();
  MX_ADC1_Init();
  MX_I2C1_Init();
  MX_I2C2_Init();
  MX_I2S1_Init();
  MX_SPI2_Init();
  MX_TIM4_Init();
  MX_TIM3_Init();
  /* USER CODE BEGIN 2 */
	// configure codec over I2C
	if (TLV_quickInit_monoGuitarPedal() != HAL_OK) {
		Error_Handler();
	}
	//Start DMA transmission
	// note: buffer size is *2 here bc our 32 bit codec will use 2 16 bit frames
	HAL_StatusTypeDef status = HAL_I2SEx_TransmitReceive_DMA(&hi2s1,
			(uint16_t*) dacPtr, (uint16_t*) adcPtr, BUFFER_SIZE);
	if (status != HAL_OK) {
		Error_Handler();
	}
	// set up processor
	fx = create_fx_processor();

	// calibrate and start DMA for the control knob ADC
	if (HAL_ADCEx_Calibration_Start(&hadc1, ADC_CALIB_OFFSET, ADC_SINGLE_ENDED)
			!= HAL_OK) {
		Error_Handler();
	}

	if (HAL_TIM_Base_Start_IT(&htim4) != HAL_OK) {
		Error_Handler();
	}

	// bring the NRST pin for the LEDs high
	HAL_GPIO_WritePin(LED_NRST_GPIO_Port, LED_NRST_Pin, GPIO_PIN_SET);

	// initialize the OLED display
	//ssd1306_Init();

	if (HAL_TIM_Base_Start_IT(&htim3) != HAL_OK) {
		Error_Handler();
	}

  /* USER CODE END 2 */

  /* Infinite loop */
  /* USER CODE BEGIN WHILE */
	while (1) {
		// check if we have the next buffer to process
		if (bufferReady) {
//			HAL_NVIC_DisableIRQ(I2C1_EV_IRQn);
//			HAL_NVIC_DisableIRQ(TIM3_IRQn);
//			HAL_NVIC_DisableIRQ(TIM4_IRQn);
//			HAL_NVIC_DisableIRQ(DMA1_Stream2_IRQn);
			convertInputBuffer();
			process_fx(fx, BUFFER_FLOAT_SIZE, inputFloatBuf, outputFloatBuf);
			convertOutputBuffer();
			bufferReady = 0;
//			HAL_NVIC_EnableIRQ(I2C1_EV_IRQn);
//			HAL_NVIC_EnableIRQ(TIM3_IRQn);
//			HAL_NVIC_EnableIRQ(TIM4_IRQn);
//			HAL_NVIC_EnableIRQ(DMA1_Stream2_IRQn);
		}
//		if (displayUpdateNeeded) {
//			displayUpdateNeeded = 0;
//			fx_update_display(fx);
//			ssd1306_UpdateScreen();
//		}
		// check the LEDs
		HAL_NVIC_DisableIRQ(I2C1_EV_IRQn);
		checkLEDs();
		checkSwitches();
		HAL_NVIC_EnableIRQ(I2C1_EV_IRQn);

    /* USER CODE END WHILE */

    /* USER CODE BEGIN 3 */
	}
  /* USER CODE END 3 */
}

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
 /* MPU Configuration */

void MPU_Config(void)
{
  MPU_Region_InitTypeDef MPU_InitStruct = {0};

  /* Disables the MPU */
  HAL_MPU_Disable();

  /** Initializes and configures the Region and the memory to be protected
  */
  MPU_InitStruct.Enable = MPU_REGION_ENABLE;
  MPU_InitStruct.Number = MPU_REGION_NUMBER0;
  MPU_InitStruct.BaseAddress = 0x0;
  MPU_InitStruct.Size = MPU_REGION_SIZE_4GB;
  MPU_InitStruct.SubRegionDisable = 0x87;
  MPU_InitStruct.TypeExtField = MPU_TEX_LEVEL0;
  MPU_InitStruct.AccessPermission = MPU_REGION_NO_ACCESS;
  MPU_InitStruct.DisableExec = MPU_INSTRUCTION_ACCESS_DISABLE;
  MPU_InitStruct.IsShareable = MPU_ACCESS_SHAREABLE;
  MPU_InitStruct.IsCacheable = MPU_ACCESS_NOT_CACHEABLE;
  MPU_InitStruct.IsBufferable = MPU_ACCESS_NOT_BUFFERABLE;

  HAL_MPU_ConfigRegion(&MPU_InitStruct);
  /* Enables the MPU */
  HAL_MPU_Enable(MPU_PRIVILEGED_DEFAULT);

}

/**
  * @brief  This function is executed in case of error occurrence.
  * @retval None
  */
void Error_Handler(void)
{
  /* USER CODE BEGIN Error_Handler_Debug */
	/* User can add his own implementation to report the HAL error return state */
	__disable_irq();
	while (1) {
	}
  /* USER CODE END Error_Handler_Debug */
}
#ifdef USE_FULL_ASSERT
/**
  * @brief  Reports the name of the source file and the source line number
  *         where the assert_param error has occurred.
  * @param  file: pointer to the source file name
  * @param  line: assert_param error line source number
  * @retval None
  */
void assert_failed(uint8_t *file, uint32_t line)
{
  /* USER CODE BEGIN 6 */
  /* User can add his own implementation to report the file name and line number,
     ex: printf("Wrong parameters value: file %s on line %d\r\n", file, line) */
  /* USER CODE END 6 */
}
#endif /* USE_FULL_ASSERT */
