hsetlik/GuitarProcessorH7/GuitarProcessorFirmware/Core/Inc/main.h

#define AUDIO_BUF_SIZE 256
#define AUDIO_SAMPLE_RATE 46875.0f
#define isample_t int32_t
#define ADC_C_Pin GPIO_PIN_0
#define ADC_C_GPIO_Port GPIOC
#define ADC_B_Pin GPIO_PIN_1
#define ADC_B_GPIO_Port GPIOC
#define ADC_D_Pin GPIO_PIN_0
#define ADC_D_GPIO_Port GPIOA
#define ADC_A_Pin GPIO_PIN_2
#define ADC_A_GPIO_Port GPIOA
#define LED_LATCH_Pin GPIO_PIN_4
#define LED_LATCH_GPIO_Port GPIOA
#define LED_CLK_Pin GPIO_PIN_5
#define LED_CLK_GPIO_Port GPIOA
#define LED_DATA_Pin GPIO_PIN_7
#define LED_DATA_GPIO_Port GPIOA
#define LED_NRST_Pin GPIO_PIN_4
#define LED_NRST_GPIO_Port GPIOC
#define SW_1_Pin GPIO_PIN_2
#define SW_1_GPIO_Port GPIOB
#define SW_2_Pin GPIO_PIN_7
#define SW_2_GPIO_Port GPIOE
#define CODEC_NRST_Pin GPIO_PIN_15
#define CODEC_NRST_GPIO_Port GPIOE
#define CODEC_SCL_Pin GPIO_PIN_10
#define CODEC_SCL_GPIO_Port GPIOB
#define CODEC_SDA_Pin GPIO_PIN_11
#define CODEC_SDA_GPIO_Port GPIOB
#define MODE_Pin GPIO_PIN_8
#define MODE_GPIO_Port GPIOC
#define BYP_Pin GPIO_PIN_9
#define BYP_GPIO_Port GPIOC
#define DBG1_Pin GPIO_PIN_1
#define DBG1_GPIO_Port GPIOD
#define DBG2_Pin GPIO_PIN_2
#define DBG2_GPIO_Port GPIOD
#define LED_SPI hspi1
