hsetlik/GuitarProcessorH7/Core/Inc/main.h

#define KNOB_MAX 65535
#define KNOB_MID 32767
#define BUFFER_SIZE 256
#define BUFFER_FLOAT_SIZE 64
#define ADC_C_Pin GPIO_PIN_0
#define ADC_C_GPIO_Port GPIOC
#define ADC_B_Pin GPIO_PIN_1
#define ADC_B_GPIO_Port GPIOC
#define ADC_A_Pin GPIO_PIN_2
#define ADC_A_GPIO_Port GPIOA
#define ADC_EXP_Pin GPIO_PIN_3
#define ADC_EXP_GPIO_Port GPIOA
#define CODEC_NRST_Pin GPIO_PIN_15
#define CODEC_NRST_GPIO_Port GPIOE
#define CODEC_SCL_Pin GPIO_PIN_10
#define CODEC_SCL_GPIO_Port GPIOB
#define CODEC_SDA_Pin GPIO_PIN_11
#define CODEC_SDA_GPIO_Port GPIOB
#define LED_LATCH_Pin GPIO_PIN_12
#define LED_LATCH_GPIO_Port GPIOB
#define LED_SCK_Pin GPIO_PIN_13
#define LED_SCK_GPIO_Port GPIOB
#define LED_NRST_Pin GPIO_PIN_14
#define LED_NRST_GPIO_Port GPIOB
#define LED_DATA_Pin GPIO_PIN_15
#define LED_DATA_GPIO_Port GPIOB
#define BYP_Pin GPIO_PIN_9
#define BYP_GPIO_Port GPIOA
#define MODE_Pin GPIO_PIN_10
#define MODE_GPIO_Port GPIOA
#define TAP_Pin GPIO_PIN_11
#define TAP_GPIO_Port GPIOA
#define DISP_SCL_Pin GPIO_PIN_6
#define DISP_SCL_GPIO_Port GPIOB
#define DISP_SDA_Pin GPIO_PIN_7
#define DISP_SDA_GPIO_Port GPIOB
#define AUDIO_SAMPLE_RATE 48828.0f
