hsetlik/GuitarProcessorH7/Core/Src/ConvolutionFIR.cpp

/*
 * Filter.cpp
 *
 *  Created on: Feb 4, 2025
 *      Author: hayden
 */

#include <ConvolutionFIR.h>

void ConvDirectFIR::init(const float* kernel){
	// grip the time-reversed kernel
	for(uint16_t idx = 0; idx < CD_KERNEL_LENGTH; idx++){
		kernelTimeReversed[CD_KERNEL_LENGTH - (idx + 1)] = kernel[idx];
	}
	// call the CMSIS init function
	arm_fir_init_f32(&firProc, CD_KERNEL_LENGTH, kernelTimeReversed, firBuf, CD_BLOCK_LENGTH);
}

void ConvDirectFIR::processChunk(float* input, float* output, uint16_t length){
	arm_fir_f32(&firProc, input, output, length);
}
/*

FIR filter designed with
http://t-filter.appspot.com

sampling frequency: 43402 Hz

Kernel length = 173

* 0 Hz - 500 Hz
  gain = 1
  desired ripple = 5 dB
  actual ripple = 4.097467313186343 dB

* 750 Hz - 900 Hz
  gain = 1.3
  desired ripple = 5 dB
  actual ripple = 4.0974673131863435 dB

* 1000 Hz - 2300 Hz
  gain = 0
  desired attenuation = -12 dB
  actual attenuation = -12.158742075755866 dB

* 2500 Hz - 21701 Hz
  gain = 0
  desired attenuation = -40 dB
  actual attenuation = -40.15874207575587 dB

*/


const float CD_Kernel[CD_KERNEL_LENGTH] ={
		  -0.0071208527855767855,
		  -0.005162958310249838,
		  -0.006708082220353774,
		  -0.008276883743951472,
		  -0.009771145249317444,
		  -0.011086164938723301,
		  -0.012117629011990618,
		  -0.01276879757012133,
		  -0.012960285908648433,
		  -0.012636822452147345,
		  -0.011773343623041868,
		  -0.010378613194328402,
		  -0.008494358476285286,
		  -0.006195963524169574,
		  -0.0035863761076325895,
		  -0.0007899639812546934,
		  0.0020592583561588242,
		  0.004823725659403927,
		  0.007374378209144512,
		  0.00959897179474267,
		  0.011414470022895255,
		  0.012767760394852088,
		  0.013638237562541927,
		  0.014043595517422841,
		  0.01403289456850413,
		  0.013676694282834221,
		  0.013067123635644093,
		  0.012306402673405385,
		  0.011487336422989965,
		  0.01070229545115118,
		  0.010014740164925935,
		  0.009469742018526527,
		  0.009081040701586014,
		  0.008835447947138357,
		  0.008693176253432402,
		  0.00859550617341363,
		  0.008469852998115944,
		  0.00823880431591013,
		  0.007829512594212608,
		  0.007181642699552285,
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
		};
