hsetlik/GuitarProcessorH7/GuitarProcessorFirmware/Core/Src/DelayLine.cpp

#include "DelayLine.h"
#include <memory>
#include "AXISRAMPool.h"
#include "DTCMPool.h"

uint16_t neededBufSize(uint16_t delay) {
	uint16_t sigBits = 0;
	while (delay) {
		sigBits++;
		delay >>= 1;
	}
	return (1 << sigBits);
}

DelayLine::DelayLine() {
	for(uint32_t i = 0; i < MAX_TAPS; ++i){
		offsets[i] = 0;
	}
}

void DelayLine::init(uint16_t size, bool shouldUseAXI) {
	useAXI = shouldUseAXI;
	maxDelay = size;
	length = neededBufSize(maxDelay);
	// allocate the buffer
	if(useAXI){
		data = AXISRAMPool::alloc(length, true);
	} else {
		data = DTCMPool::alloc(length, true);
	}
	// initialize the bitmask
	mask = length - 1;
	// set the main delay tap to max
	offsets[TAP_MAIN] = mask + 1 - maxDelay;
}

void DelayLine::setDelay(uint8_t tap, uint16_t delay) {
	offsets[tap] = mask + 1 - delay;
}

DelayLine::~DelayLine() {
}

#ifndef INLINE_DELAY_ACCESS

float DelayLine::read(uint8_t tap, uint16_t cycle){
	return data[(cycle + offsets[tap]) & mask];

}

void DelayLine::write(uint16_t cycle, float input){
	data[cycle & mask] = input;
}

float DelayLine::process(uint16_t cycle, float input){
	write(cycle, input);
	return read(TAP_MAIN, cycle);
}
#endif
