hsetlik/GuitarProcessorH7/GuitarProcessorFirmware/Core/Inc/Dattorro.h

#ifndef INC_DATTORRO_H_
#define INC_DATTORRO_H_
/* Dattorro Reverb implementation ======================================
 * Based on the reverb described in his 1997 paper found here:
 * https://ccrma.stanford.edu/~dattorro/EffectDesignPart1.pdf
 * largely a C++-ified version of the 'dattorro-verb' C implementation:
 * https://github.com/el-visio/dattorro-verb
 * */
#include "AXISRAMPool.h"
#ifdef __cplusplus
#include "DelayLine.h"
#include "FxAlgorithm.h"
#include "NormRange.h"
#define MAX_PREDELAY 4400


class Dattorro {
private:
	// in order of the main algorithm:
	DelayLine preDelay;
	float preFilter;
	// input diffusors
	DelayLine inDiffusion[4];

	// store the last input for mixing in dry signal
	float drySample;

	// the two 'tanks'
	DelayLine decayDiffusion1[2];
	DelayLine decayDiffusion2[2];
	DelayLine preDampingDelay[2];
	DelayLine postDampingDelay[2];
	float damping[2];
	// cycle to pass the delay lines
	uint16_t t;
public:
	// reverb settings
	float preFilterAmt;
	float inputDiff1Amt;
	float inputDiff2Amt;
	float decayDiff1Amt;
	float decayDiff2Amt;
	float dampingAmt;
	float decayAmt;

	//=====================================================
	Dattorro();
	~Dattorro();
	float processMono(float input);
	void processStereo(float input, float* outL, float* outR);
	/*controls are, left to right:
		1. pre-filter
		2. damping
		3. decay
		4. wet/dry	
	*/ 
	// all these should take 0-1 values
	void setPrefilter(float value);
	void setDamping(float value);
	void setDecay(float value);
	void setWetLevel(float value);
private:
	NormRange preFilterRange;
	NormRange dampRange;
	NormRange decayRange;
	NormRange wetRange;
	float wetGain;
	float dryGain;

	void processIn(const float input);
	float getLeft();
	float getRight();
};
//--------------------------------------------------------------

class Dattorro1Alg : public FxAlgorithm {
private:
    Dattorro verb;
public:
    Dattorro1Alg();
    ~Dattorro1Alg() override{}
    void processChunkMono(float* inBuf, float* outBuf, uint32_t numSamples) override;
    void processChunkStereo(float* inL, float* inR, float* outL, float* outR, uint32_t numSamples) override;
    void updateParams(pedal_state_t* ps) override;

};

#endif

#ifdef __cplusplus
#define EXTERNC extern "C"
#else
#define EXTERNC
#endif

/* ----C-FRIENDLY BINDINGS GO HERE------*/

#undef EXTERNC

#endif /* INC_DATTORRO_H_ */
