hsetlik/GuitarProcessorH7/GuitarProcessorFirmware/Core/Src/AXISRAMPool.cpp

#include "AXISRAMPool.h"

static constexpr size_t POOL_FLOATS = 55000;

static float pool[POOL_FLOATS] __attribute__((section(".axisram_pool")));
static size_t poolOffset = 0;

float* AXISRAMPool::alloc(size_t numFloats, bool zeroValues) {
    float* ptr = pool + poolOffset;
    poolOffset += numFloats;
    if(zeroValues){
        for(size_t i = 0; i < numFloats; ++i){
            ptr[i] = 0.0f;
        }
    } 
    return ptr;
}

void AXISRAMPool::freePool(){
    poolOffset = 0;
}

bool AXISRAMPool::poolInUse(){
    return poolOffset > 0;
}
