hsetlik/GuitarProcessorH7/(commit log)

2025-01-13 audio codec schematic
    [Audio.kicad_sch, GuitarProcessorBoard.kicad_pcb, GuitarProcessorBoard.kicad_sch]
2025-01-21 basic MCU pinout, IO headers
    [Audio.kicad_sch, GuitarProcessorBoard.kicad_sch, MCU.kicad_sch]
2025-01-21 control wiring
    [Audio.kicad_sch, MCU.kicad_sch]
2025-01-21 switched to shift register LEDs
    [MCU.kicad_sch]
2025-01-21 added analog wet/dry control
    [Audio.kicad_sch, MCU.kicad_sch]
2025-01-21 control/ enclosure layout
    [Audio.kicad_sch, GuitarProcessorBoard.kicad_pcb, MCU.kicad_sch]
2025-01-21 starting layout
    [Audio.kicad_sch, GuitarProcessorBoard.kicad_pcb, MCU.kicad_sch]
2025-01-22 removed encoder and back btn
    [GuitarProcessorBoard.kicad_pcb, MCU.kicad_sch]
2025-01-22 first layout
    [Audio.kicad_sch, GuitarProcessorBoard.kicad_pcb, MCU.kicad_sch]
2025-01-23 routing rd one
    [GuitarProcessorBoard.kicad_pcb, MCU.kicad_sch]
2025-01-24 routed & DRC passing
    [GuitarProcessorBoard.kicad_pcb, MCU.kicad_sch]
2025-01-24 silkscreen, stitching vias
    [GuitarProcessorBoard.kicad_pcb]
2025-01-24 more test points, trace clean up
    [GuitarProcessorBoard.kicad_pcb, MCU.kicad_sch]
2025-01-24 rev1 gerber
    [GuitarProcessorBoard.kicad_pcb]
2025-01-24 added BOM
2025-01-24 enclosure SVG stuff
    [GuitarProcessorBoard.kicad_pcb]
2025-01-27 processing callback set up
    [Audio.kicad_sch, GuitarProcessorBoard.kicad_pcb, MCU.kicad_sch]
2025-01-29 more driver stuff
2025-02-04 set up DMA for control knobs
2025-02-04 FxAlgorithm scheme, led shift register driver
2025-02-04 convolution FIR filter implementation
2025-02-13 IIR filter general form
2025-02-14 cascade, pole filter base
2025-02-14 pole filter s/z transforms
2025-02-14 butterworth analog prototypes
2025-02-15 Butterworth shelf filters
2025-02-15 added display driver
2025-02-18 Added DMA mode to display driver
2025-02-20 switched to 48kHz audio
2025-07-11 codec I2C bus working in hardware
2025-07-12 getting ADC data on 32 bit frames
2025-07-12 DAC registers set up
    [Audio.kicad_sch, MCU.kicad_sch]
2025-07-12 single-ended output working
    [Audio.kicad_sch, MCU.kicad_sch]
2025-07-13 differential output stage
    [Audio.kicad_sch, MCU.kicad_sch]
2025-07-13 schematic changes
    [Audio.kicad_sch]
2025-07-13 differential output sim
    [Audio.kicad_sch, GuitarProcessorBoard.kicad_pcb, MCU.kicad_sch]
2025-07-13 routing start
    [Audio.kicad_sch, GuitarProcessorBoard.kicad_pcb, MCU.kicad_sch]
2025-07-13 DRC passing
    [Audio.kicad_sch, GuitarProcessorBoard.kicad_pcb]
2025-07-17 alg. switch handling
2025-07-17 control knob ADC working
2025-07-17 moved ADC callback to timer 4
2025-07-17 bypass switching works
2025-07-24 more decoupling caps, return vias
    [GuitarProcessorBoard.kicad_pcb, MCU.kicad_sch]
2025-07-24 timer interrupt for screen redraws
2025-07-28 display interrupt fixed
2025-07-28 Display DMA mode works
2025-07-28 moved per-page command messages to DMA as well
2025-07-28 bumped I2C clock to 220khZ, 18fps working
2026-01-12 new split power branch
    [Audio.kicad_sch, GuitarProcessorBoard.kicad_pcb, MCU.kicad_sch]
2026-01-13 stitching vias, prettier layout
    [GuitarProcessorBoard.kicad_pcb, MCU.kicad_sch]
2026-01-18 rev2 sent to fab
    [GuitarProcessorBoard.kicad_pcb]
2026-01-25 updated to kicad 9, new BOM file
    [Audio.kicad_sch, GuitarProcessorBoard.kicad_pcb, GuitarProcessorBoard.kicad_sch, MCU.kicad_sch]
2026-02-01 migrated to new cube MX version, flashing on new board works
    [MCU.kicad_sch]
2026-02-03 switched off display stuff for now
2026-04-02 audio codec driver set up
2026-04-06 audio DMA finally working wooot
2026-04-06 switched back to 32 bit word size
2026-04-06 fixed linker script, switched to 12 bit for knob readings
    [GuitarProcessorFirmware.ioc, main.c]
2026-04-07 back 2 32 bit word length
    [Audio.kicad_sch]
2026-04-11 tweaked resistor for input/output gain
    [Audio.kicad_sch]
2026-04-12 PedalState, button reading and LEDs
2026-04-12 sample to float conversion set up
2026-04-12 24 bit words working, sample to float conv working
2026-04-12 fixed jumping to alg2 on startup
    [GuitarProcessorFirmware.ioc, main.c, main.h]
2026-04-13 added AXISRAMPool, reverb is still too slow
    [AXISRAMPool.cpp, AXISRAMPool.h, Dattorro.cpp, Dattorro.h, DelayLine.cpp, DelayLine.h, FxProcessor.h, PedalState.c]
2026-04-18 updated schematic, re-annotated
    [Audio.kicad_sch, MCU.kicad_sch]
2026-04-19 new layout
    [Audio.kicad_sch, GuitarProcessorBoard.kicad_pcb, GuitarProcessorBoard.kicad_sch, MCU.kicad_sch]
2026-04-19 prelim. routing, DRC passing
    [Audio.kicad_sch, GuitarProcessorBoard.kicad_pcb, MCU.kicad_sch]
2026-04-20 minor tweaks
    [GuitarProcessorBoard.kicad_pcb]
2026-04-20 new layout, pinout switcharoo
    [Audio.kicad_sch, GuitarProcessorBoard.kicad_pcb, MCU.kicad_sch]
2026-04-20 prelim routing, DRC passing
    [GuitarProcessorBoard.kicad_pcb, MCU.kicad_sch]
2026-04-21 stitching vias, silkscreen, spacing
    [GuitarProcessorBoard.kicad_pcb]
2026-04-27 comb and allpass filters for Freeverb impl
    [GuitarProcessorBoard.kicad_pcb]
2026-05-01 board too tall ughhhhh
    [GuitarProcessorBoard.kicad_pcb, MCU.kicad_sch]
2026-05-01 shorter board
    [GuitarProcessorBoard.kicad_pcb]
2026-05-01 rev4 sent to fab
    [GuitarProcessorBoard.kicad_pcb]
2026-05-02 handling for 4th knob and switches
2026-05-02 stereo processing callback in main, debug pin access
2026-05-10 fixed drill pattern
    [GuitarProcessorBoard.kicad_pcb]
2026-05-12 rev4 code flashing
    [GuitarProcessorBoard.kicad_pcb]
2026-05-17 switched to H750VBT6
2026-05-17 switched to new linker script
2026-05-17 updated schem for new MCU part num
    [MCU.kicad_sch]
2026-05-21 Code flashing w/ H750 soldered wooo
2026-05-21 fixed weirdness w adc conversions, schroeder and freeverb working
    [FxProcessor.h, GuitarProcessorFirmware.ioc, main.c]
2026-05-21 fixes for Dattorro alg
    [AXISRAMPool.cpp, AXISRAMPool.h, Dattorro.cpp, Dattorro.h, DelayLine.cpp, FxProcessor.cpp, GuitarProcessorFirmware.ioc, main.c]
2026-05-23 input/output opamp stages changed
    [Audio.kicad_sch, MCU.kicad_sch]
2026-05-23 basic routing, DRC passes
    [Audio.kicad_sch, GuitarProcessorBoard.kicad_pcb, MCU.kicad_sch]
2026-05-23 stitching vias, silkscreen, corner bevels
    [GuitarProcessorBoard.kicad_pcb]
2026-05-24 rev5 sent to fab
    [GuitarProcessorBoard.kicad_pcb]
2026-05-27 tracked BOM
2026-05-27 generic button debouncing
2026-06-04 rev5 board flashing, mode buttons working
2026-06-06 Dattorro verb running fast enough woo
    [Audio.kicad_sch]
